out-sider/3D-scanner/README.md

# 3D-scanner
a cheap optical 3D scanner programmed with python (and OpenCV, numpy, Arduino)
