out-sider/3D-scanner/(commit log)

2017-09-25 介绍原理的pdf
2017-09-25 扫描主程序 需要配合单片机系统
    tested on python 3.6
2017-09-25 用来瞄准步进电机轴用的辅助程序
2017-09-25 相机校准程序
    需要棋盘格，并根据棋盘格的大小修改程序参数
2017-09-25 一个扫描得到的点云文件
2017-09-25 密集扫描得到的点云文件，格式为.pcd
2017-09-25 单片机程序
    tested on Arduino Uno 引脚需要根据实际连线修改
